VictorMarinchev/Electric-Guitar-amplifier/README.md

# Electric-Guitar-amplifier
Custom electric guitar amp with added distortion.
